amirulfahmiii920-beep/AG3-Smart-irrigation-prototype/(commit log)

2026-10-28 Rewrite README with diagrams, wiring, model and test results
    Adds figures from the IDP report (no faces) under docs/images and
    replaces the old Readme.md.
    Claude-Session: https://claude.ai/code/session_01UKyx746sSUM5YejWzb3FtA
2026-10-28 URL-encode Telegram messages, tidy pump settings, drop costs from README
    - Encode message text so +, & and # reach Telegram unchanged
    - Fix PUMP_DURATION comment (value is 1 second)
    - Remove unused clean-tank pump pin (GPIO 19 has no relay channel)
    - README: record the fixes and remove prices from the bill of materials
    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
    [AG3_Smart_Irrigation.ino]
